ArthurAdmiraal/POxiM-shield/Renders/POxiM-testboard-front_May18th.png

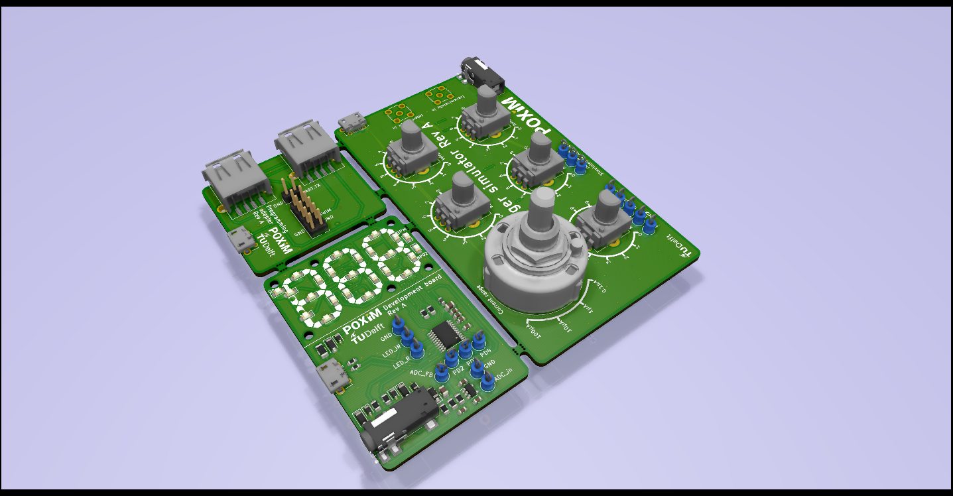
Renders/POxiM-testboard-front_May18th.png
