ArthurAdmiraal/POxiM-shield/Renders/POxiM-displaytester-front_May15th.png

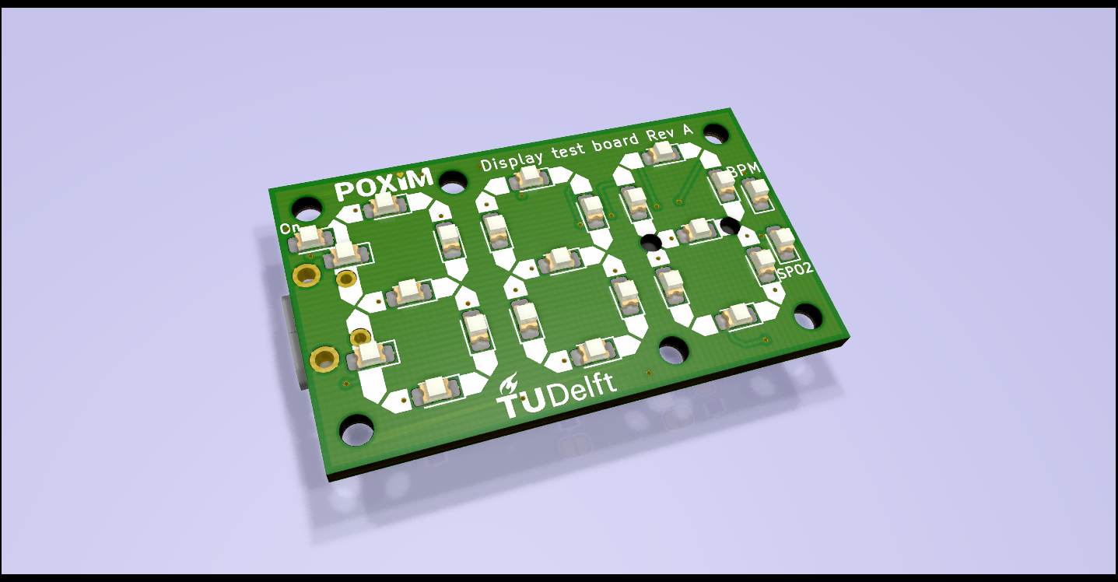
Renders/POxiM-displaytester-front_May15th.png
