ArthurAdmiraal/POxiM-shield/README.md

# POxiM-shield
 Prototyping Arduino shield for POxiM Pulse/Oxymeter
