ArthurAdmiraal/POxiM-shield/Documentation/FingerSensor-schematic-overview.png

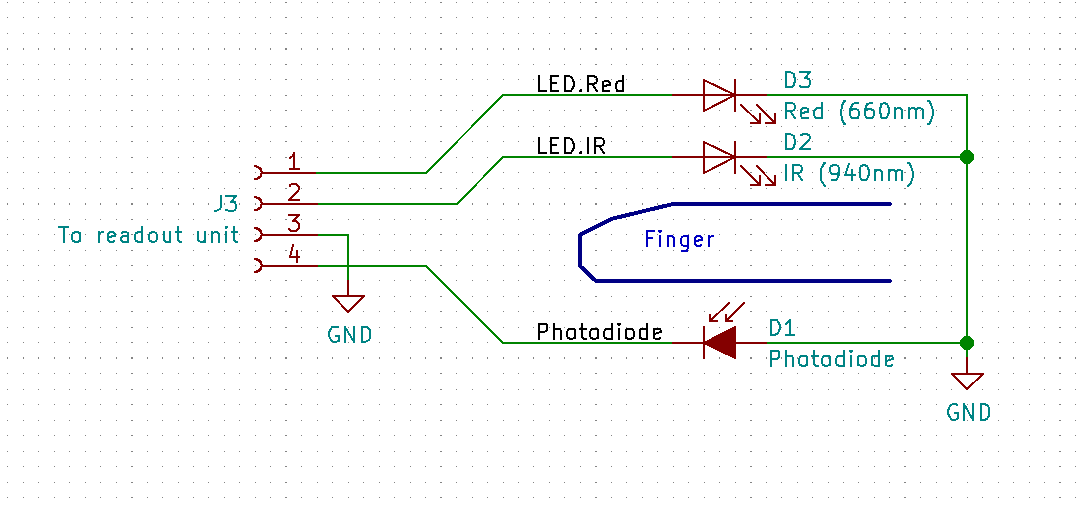
Documentation/FingerSensor-schematic-overview.png
