ArthurAdmiraal/POxiM-shield/Documentation/POxiM-bedofnails-overview.png

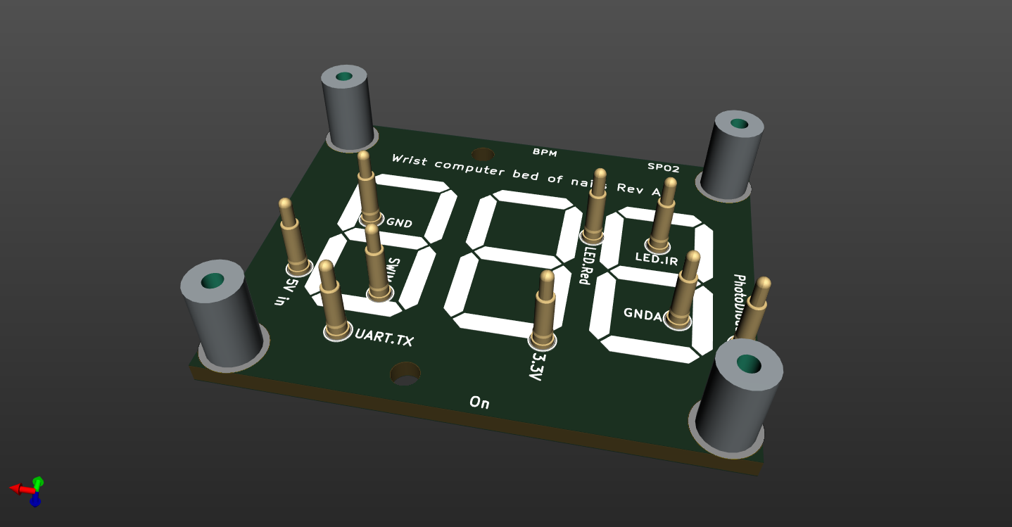
Documentation/POxiM-bedofnails-overview.png
