ArthurAdmiraal/POxiM-shield/Documentation/POxiM-wristcomputer-block diagram.png

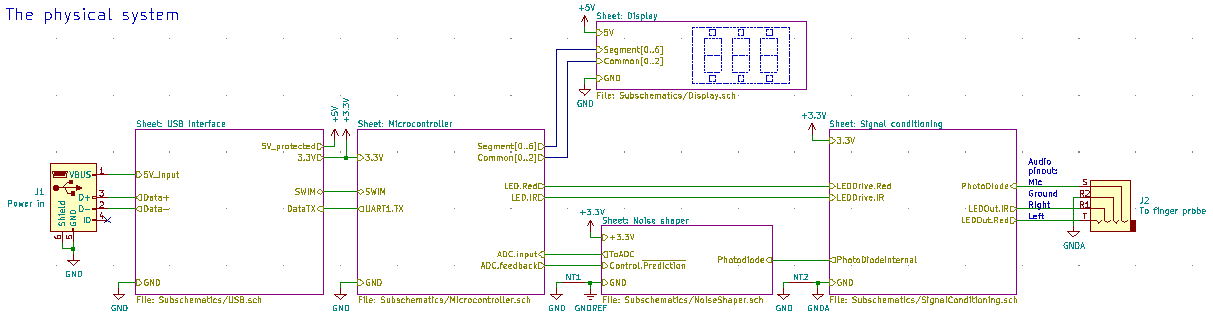
Documentation/POxiM-wristcomputer-block diagram.png
