ArthurAdmiraal/POxiM-shield/Documentation/POxiM-wristcomputer-headon.png

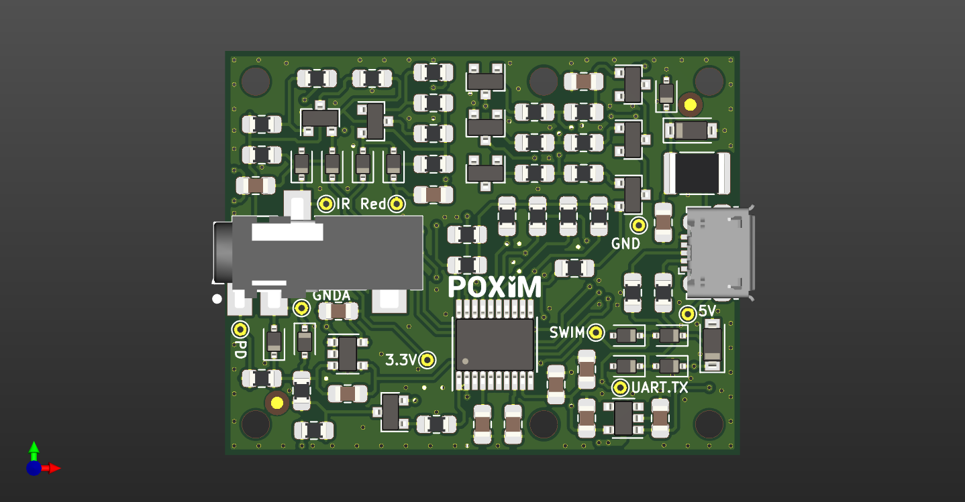
Documentation/POxiM-wristcomputer-headon.png
