ArthurAdmiraal/POxiM-shield/Figures/Coupling_nobias.png

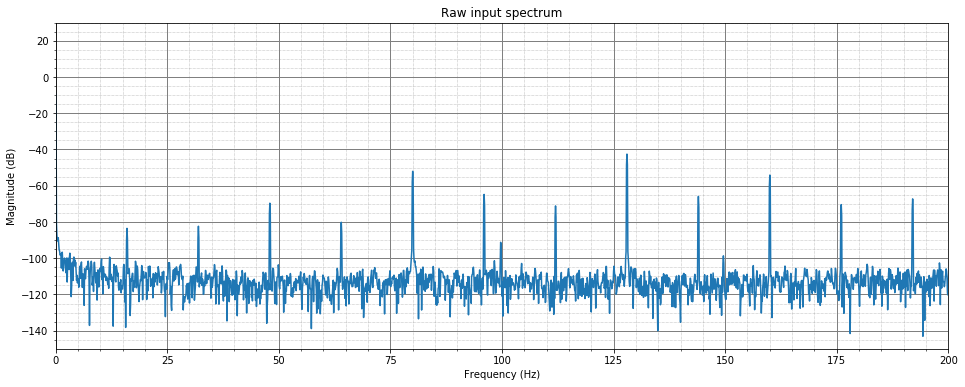
Figures/Coupling_nobias.png
