ArthurAdmiraal/POxiM-shield/Figures/POxiM-SignalChain-MidLevel.png

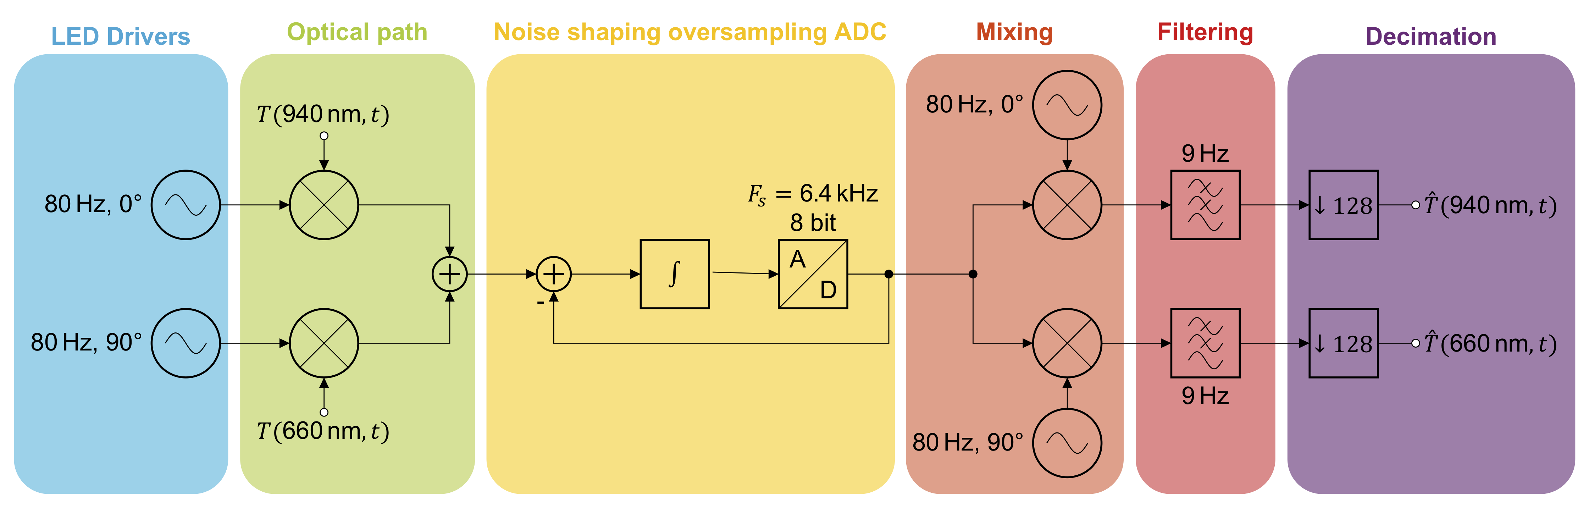
Figures/POxiM-SignalChain-MidLevel.png
