ArthurAdmiraal/POxiM-shield/Mechanical/Decals/POxiM-wristcomputer-Back.png

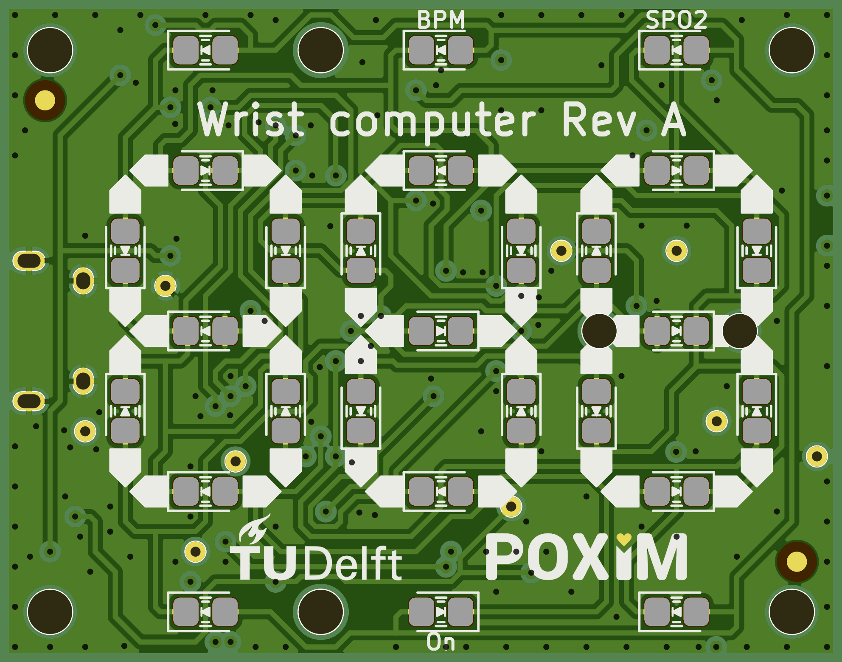
Mechanical/Decals/POxiM-wristcomputer-Back.png
