ArthurAdmiraal/POxiM-shield/Mechanical/Decals/POxiM-wristcomputer-Front.png

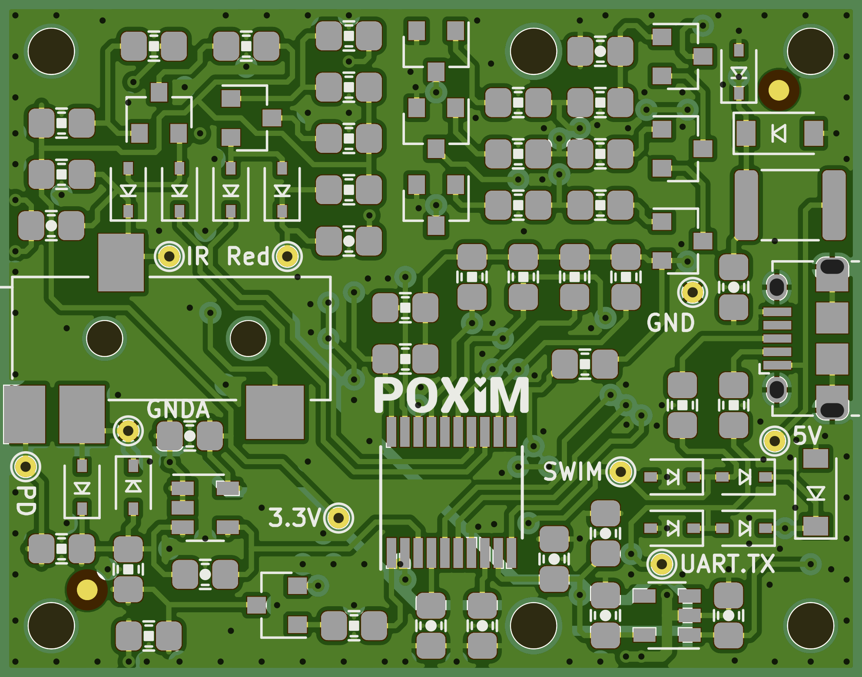
Mechanical/Decals/POxiM-wristcomputer-Front.png
