ArthurAdmiraal/POxiM-shield/Renders/POxiM-displaytester-back_May15th.png

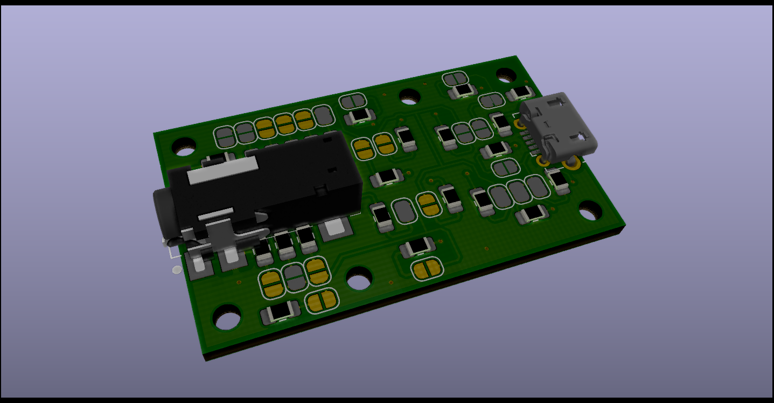
Renders/POxiM-displaytester-back_May15th.png
