ArthurAdmiraal/POxiM-shield/Renders/POxiM-wristcomputer-back_July3rd.png

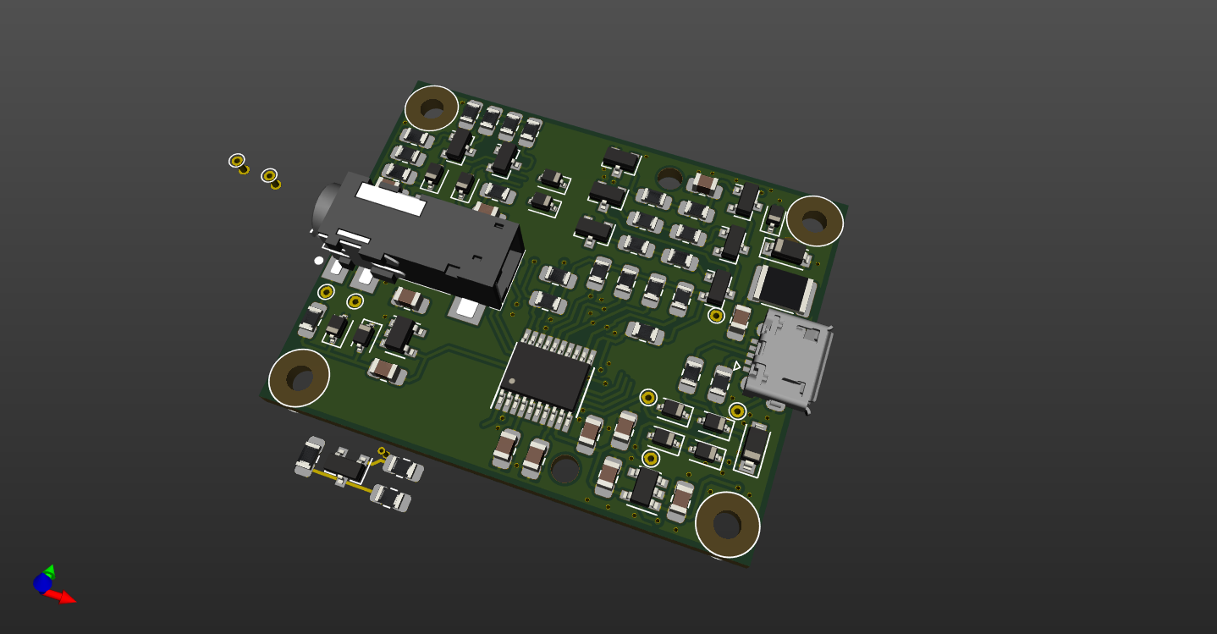
Renders/POxiM-wristcomputer-back_July3rd.png
