ArthurAdmiraal/POxiM-shield/Renders/POxiM-wristcomputer-back_July5th.png

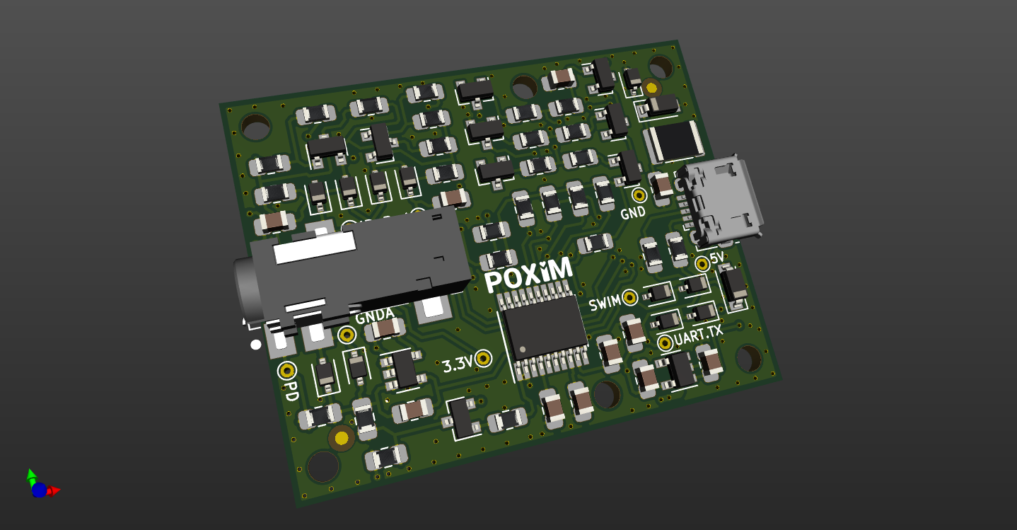
Renders/POxiM-wristcomputer-back_July5th.png
