ArthurAdmiraal/POxiM-shield/Renders/POxiM-wristcomputer-back_May15th.png

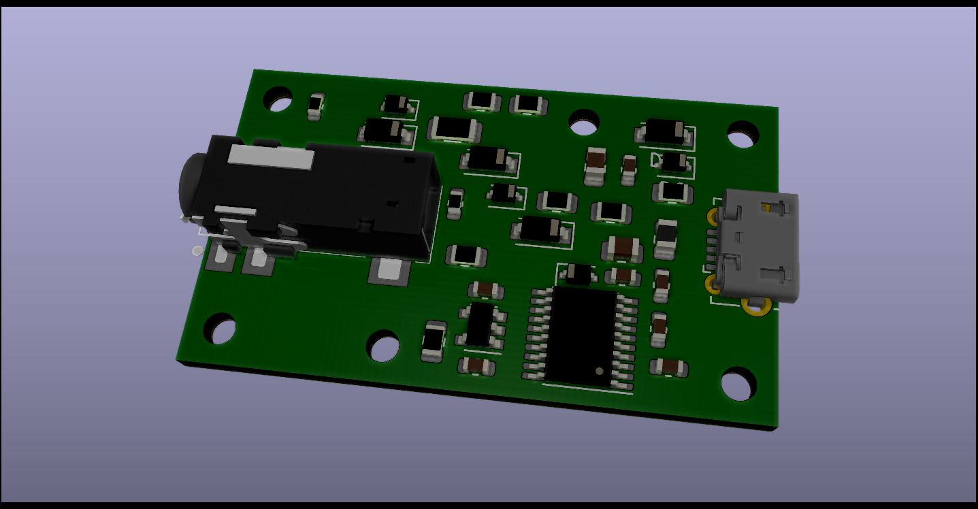
Renders/POxiM-wristcomputer-back_May15th.png
