ArthurAdmiraal/POxiM-shield/Renders/POxiM-wristcomputer-front_July3rd.png

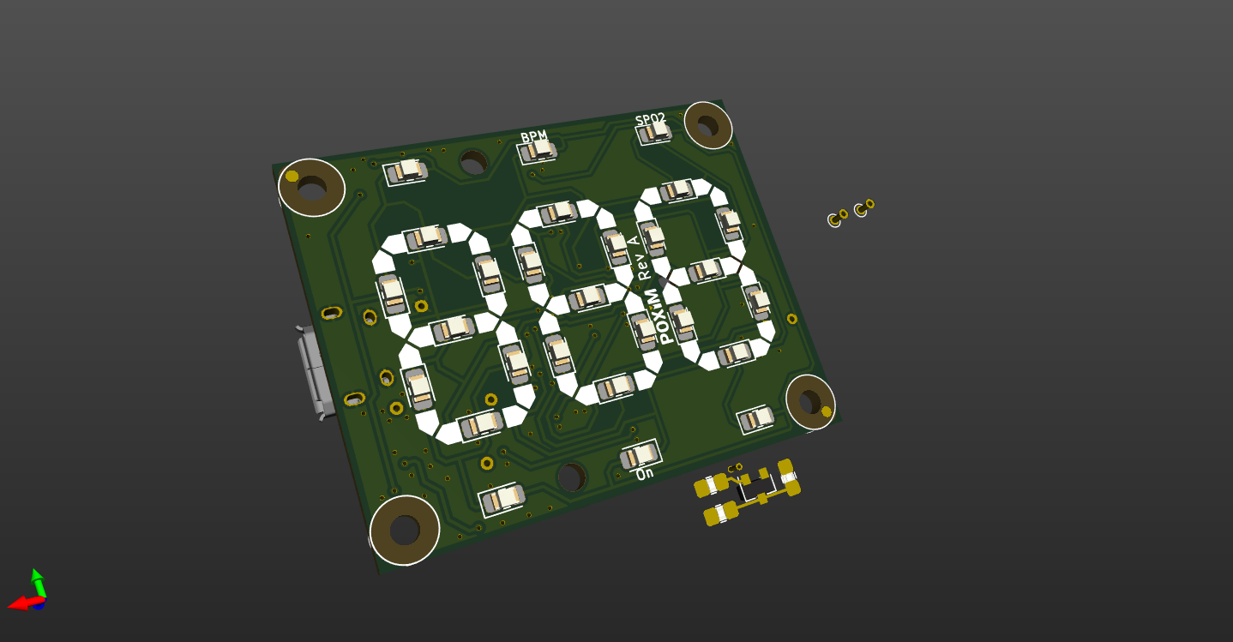
Renders/POxiM-wristcomputer-front_July3rd.png
