ArthurAdmiraal/POxiM-shield/Renders/POxiM-wristcomputer-front_July5th.png

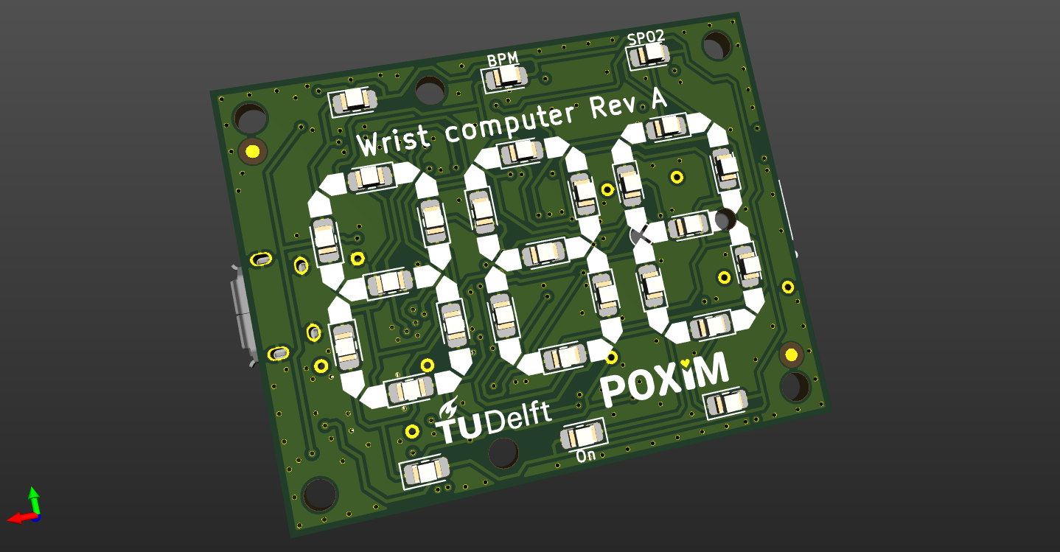
Renders/POxiM-wristcomputer-front_July5th.png
