ArthurAdmiraal/POxiM-shield/Renders/POxiM-wristcomputer-front_May15th.png

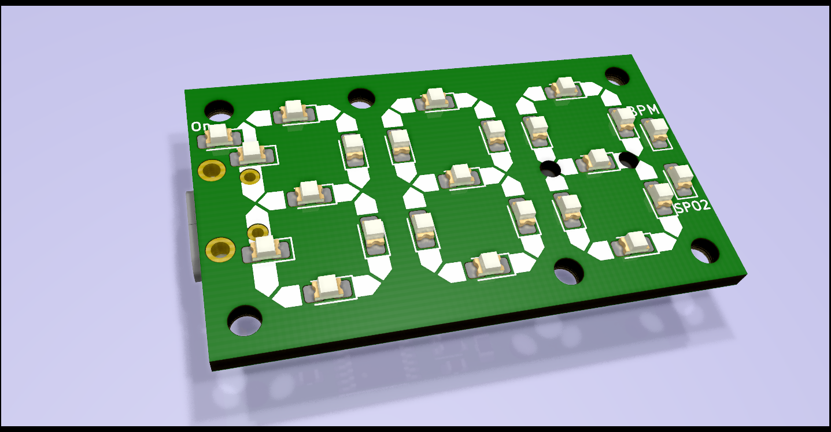
Renders/POxiM-wristcomputer-front_May15th.png
