ArthurAdmiraal/POxiM-shield/Fabrication/AssemblyDiagram.pdf

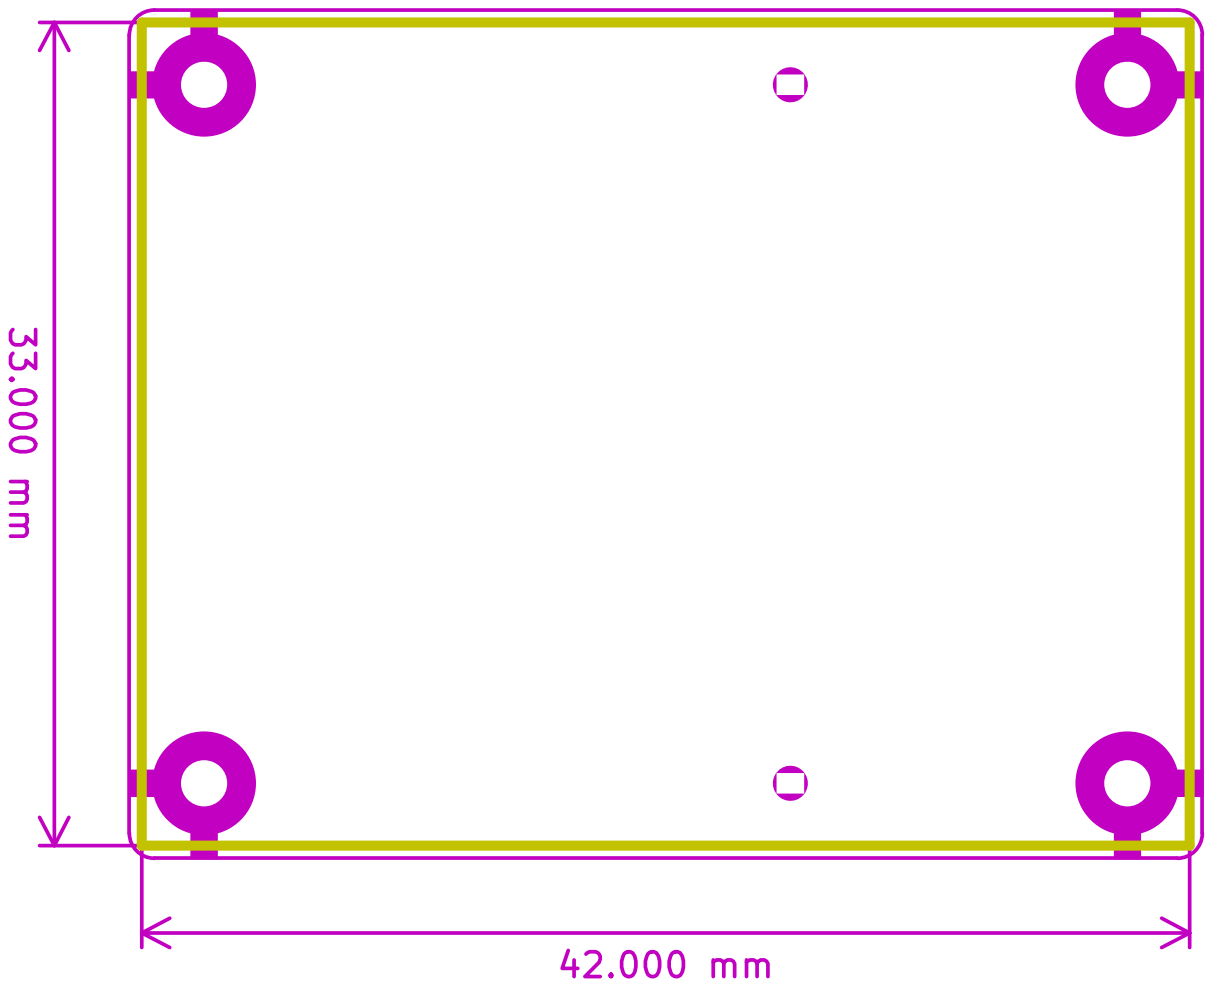
[picture p18: page 1]

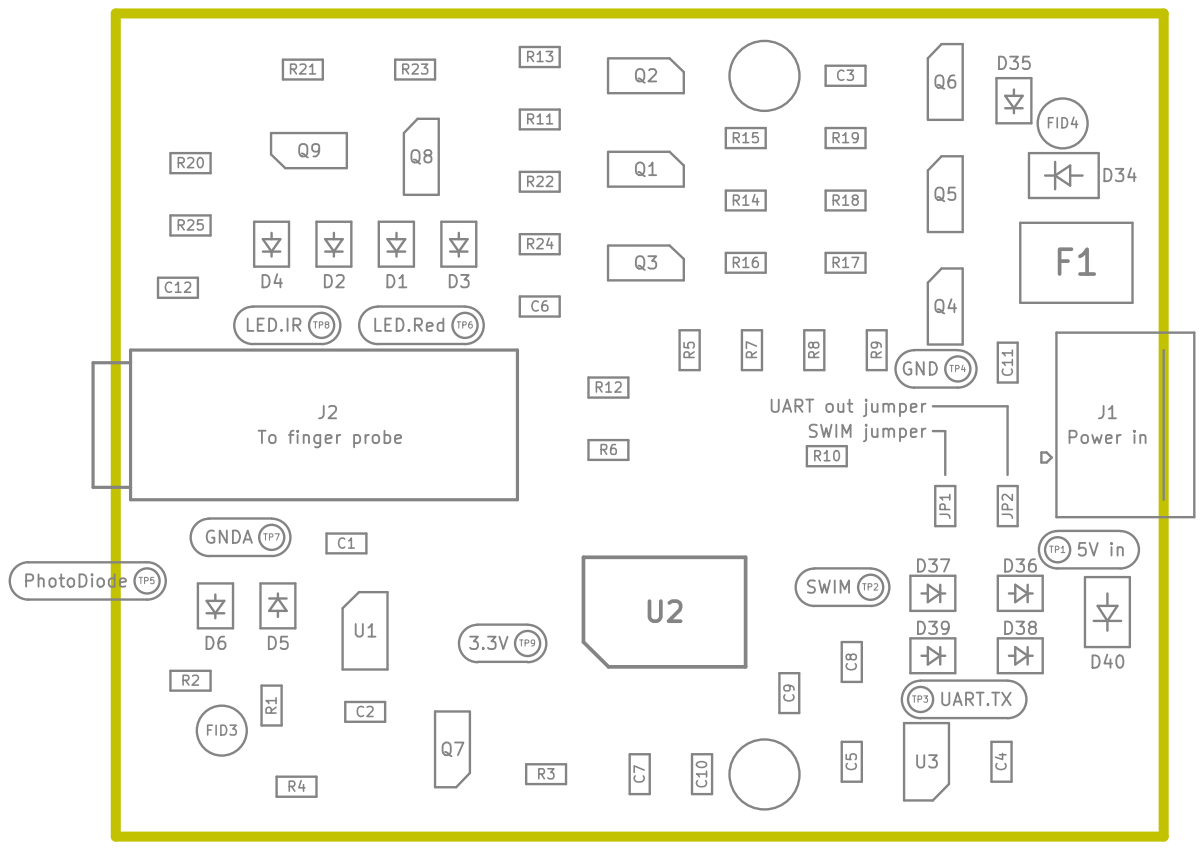
[picture p19: page 2]

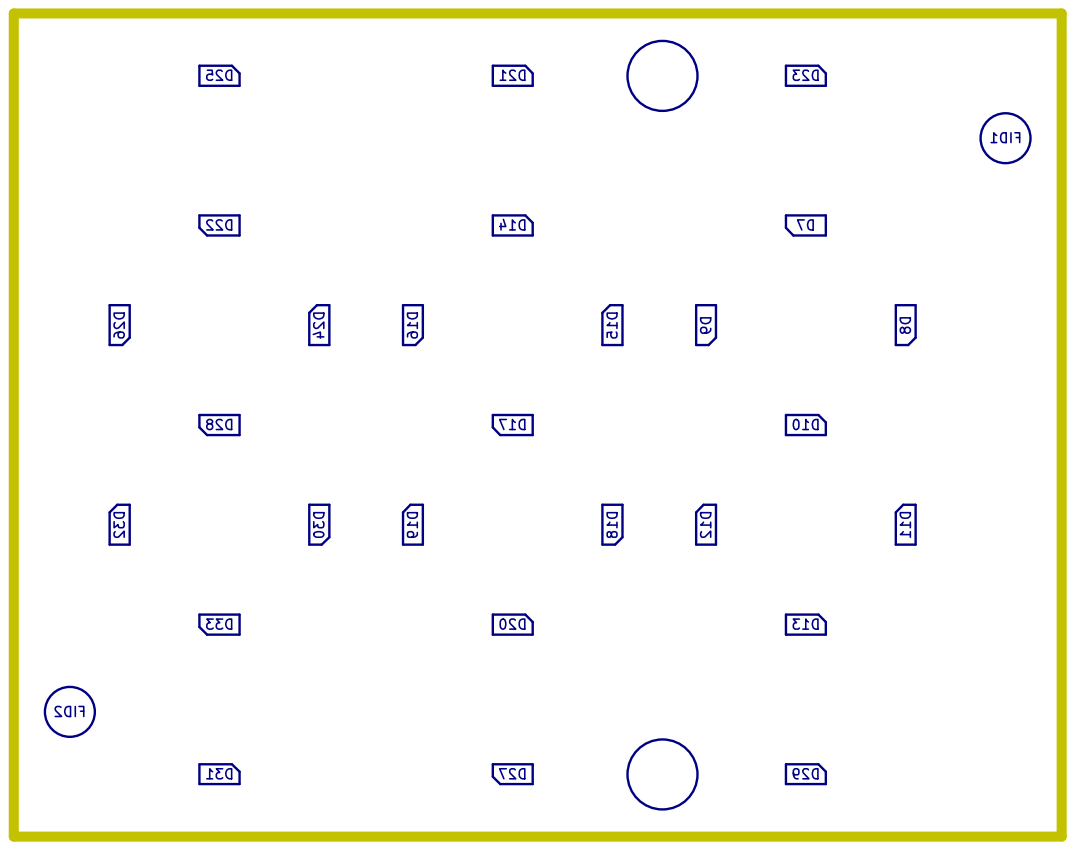
[picture p20: page 3]
