ArthurAdmiraal/POxiM-shield/Simulations/RiseTimeTest.asc

Q1: pnp; 2N3906
R1: res; 100k
R2: res; 4.7Meg
R3: res; 100k
V1: voltage; 3.3V
V2: voltage; PULSE(3.3V 0V 1m 10n 10n 1m 2m 1)
Named nets: 0
.tran 0 3m 0 10n
