ArthurAdmiraal/POxiM-shield/Simulations/CurrentSourceTest.asc

Q1: pnp
R1: res; 47
R2: res; 1k
R3: res; 3.3k
V1: voltage; 5.5V
V2: voltage; 3.3V
Named nets: 0
.dc V2 0V 5.5V
