ArthurAdmiraal/POxiM-shield/Simulations/IsolationTest.asc

M1: nmos; Si7336ADP
R1: res; 100
V1: voltage; 5.5V
V2: voltage; 5.5V
Named nets: 0
.dc V1 0 5.5V
