ArthurAdmiraal/POxiM-shield/Simulations/MOSCurrentSourceTest.asc

M1: pmos; AO6407
R1: res; 100
V1: voltage; 5.5V
V2: voltage; 3V
V3: voltage; 4.3V
Named nets: 0
.dc V1 0 4.3V
