ArthurAdmiraal/POxiM-shield/POxiM-wristcomputer.kicad_pcb

## KiCad design POxiM-wristcomputer.kicad_pcb (2020-07-16)

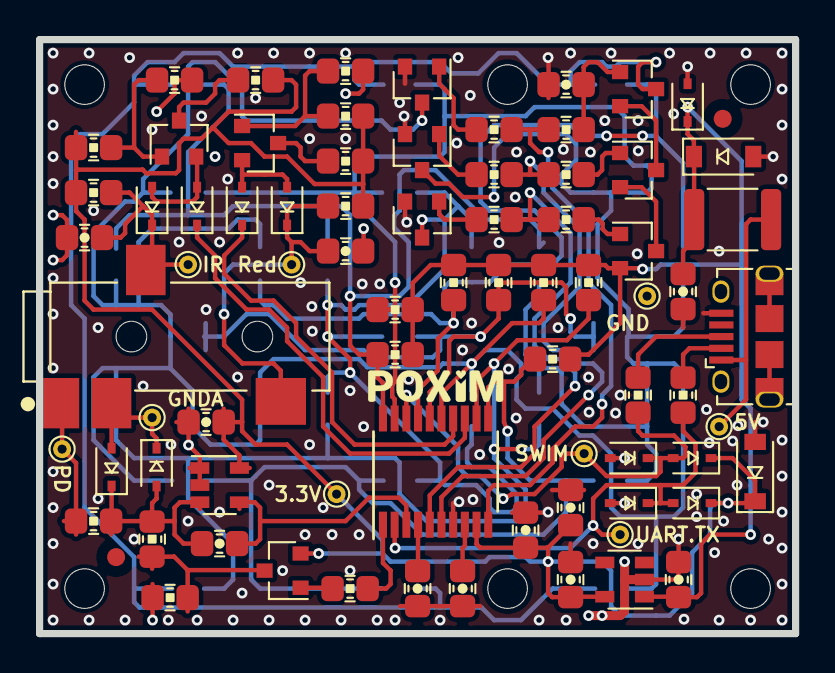
[picture p27: board POxiM-wristcomputer.kicad_pcb from above]

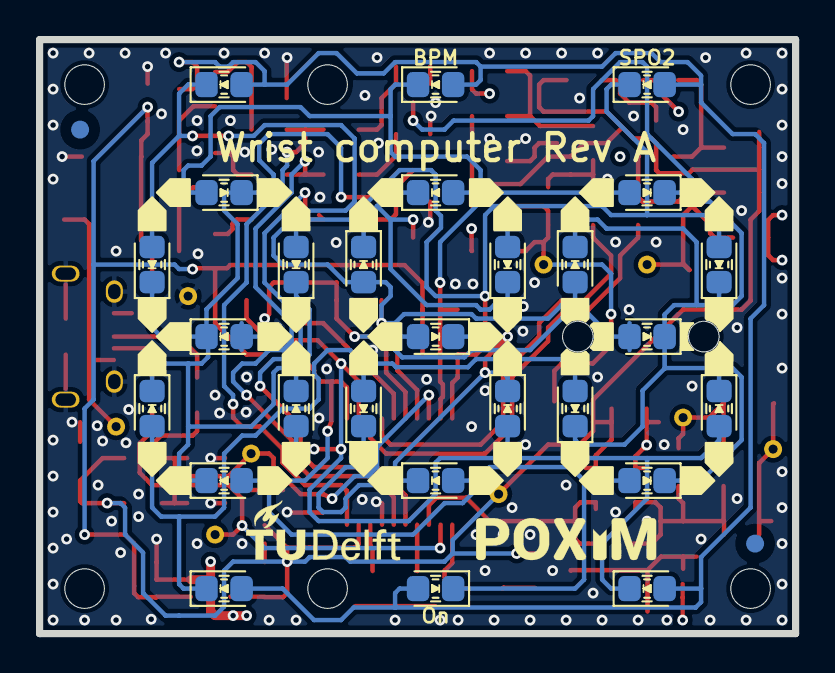
[picture p28: board POxiM-wristcomputer.kicad_pcb from below]

Board: 4 copper layers, 42.0 x 33.0 mm, 115 parts (35 on the bottom side), 50 nets.

Parts:
C1, C3, C7, C9, C11: 100nF; C_0805_2012Metric_0603_1608Metric
C2: 39pF; C_0805_2012Metric_0603_1608Metric
C4, C5, C6, C8, C12: 2.2µF; C_0805_2012Metric_0603_1608Metric
C10: 470nF; C_0805_2012Metric_0603_1608Metric
D1, D2, D3, D4, D5, D6, D35, D36, D37, D38, D39: Schottky; D_SOD-323
D7, D8, D9, D10, D11, D12, D13, D14, D15, D16, D17, D18, D19, D20, D21, D22, D23, D24, D25, D26, D27, D28, D29, D30, D31, D32, D33: LED; LED_0805_2012Metric_0603_1608Metric
D34: 6.8V; D_SOD-123
D40: 5.6V; D_SOD-123
F1: 500mA; R_1812_4532Metric
FID1, FID2, FID3, FID4: Fiducial; Fiducial_1mm_Mask2mm
H1, H2, H3, H4: MountingHole; MountingHole_2.2mm_M2
H5, H6: AlignmentHole; AlignmentHole_2.2mm_M2
J1: Power in; USB_Micro-B_Amphenol_10103594-0001LF_Horizontal
J2: To finger probe; CUI_SJ-43514-SMT
JP1: SWIM jumper; R_0805_2012Metric_0603_1608Metric
JP2: UART out jumper; R_0805_2012Metric_0603_1608Metric
NT1, NT2: Net-Tie_2; NetTie-2_SMD_Pad0.5mm
Q1, Q2, Q3: MMBT3904,215; SOT-23
Q4, Q5, Q6, Q7, Q8, Q9: PMBT3906,215; SOT-23
R1: 4.7MΩ; R_0805_2012Metric_0603_1608Metric
R2, R24, R25: 33kΩ; R_0805_2012Metric_0603_1608Metric
R3, R4: 100kΩ; R_0805_2012Metric_0603_1608Metric
R5, R6, R7, R8, R9, R10, R12: 560Ω; R_0805_2012Metric_0603_1608Metric
R11, R20: 2.2kΩ; R_0805_2012Metric_0603_1608Metric
R13, R14, R15, R16, R17, R18, R19, R21: 3.3kΩ; R_0805_2012Metric_0603_1608Metric
R22, R23: 68Ω; R_0805_2012Metric_0603_1608Metric
TP1: 5V in; TestPoint_THTPad_D1.0mm_Drill0.5mm
TP2: SWIM; TestPoint_THTPad_D1.0mm_Drill0.5mm
TP3: UART.TX; TestPoint_THTPad_D1.0mm_Drill0.5mm
TP4: GND; TestPoint_THTPad_D1.0mm_Drill0.5mm
TP5: PhotoDiode; TestPoint_THTPad_D1.0mm_Drill0.5mm
TP6: LED.Red; TestPoint_THTPad_D1.0mm_Drill0.5mm
TP7: GNDA; TestPoint_THTPad_D1.0mm_Drill0.5mm
TP8: LED.IR; TestPoint_THTPad_D1.0mm_Drill0.5mm
TP9: 3.3V; TestPoint_THTPad_D1.0mm_Drill0.5mm
U1: LM321; SOT-23-5
U2: STM8S003F3P; TSSOP-20_4.4x6.5mm_P0.65mm
U3: MIC5504-3.3YM5; SOT-23-5

Connections:
+3V3: C1.1, C5.1, C8.1, C9.1, D36.1, D38.1, D40.1, Q7.2, R11.2, R20.2, R22.2, R23.2, R24.2, R25.2, TP9.1, U1.5, U2.9, U3.5
+5V: C4.1, C11.1, D34.1, D35.1, F1.1, Q4.2, R5.1, R6.1, R7.1, R8.1, R9.1, R10.1, R12.1, U3.1
/Display/Common0: R14.2, R18.2, U2.6
/Display/Common1: R16.2, R17.2, U2.5
/Display/Common2: R15.2, R19.2, U2.10
/Display/Segment0: D7.2, D14.2, D21.1, D22.2, R12.2, U2.19
/Display/Segment1: D8.2, D15.2, D23.1, D24.2, R5.2, U2.17
/Display/Segment2: D9.2, D16.2, D25.1, D26.2, R6.2, U2.20
/Display/Segment3: D10.2, D17.2, D28.2, R7.2, U2.16
/Display/Segment4: D11.2, D18.2, D29.1, D30.2, R8.2, U2.15
/Display/Segment5: D12.2, D19.2, D31.1, D32.2, R9.2, U2.12
/Display/Segment6: D13.2, D20.2, D27.1, D33.2, R10.2, U2.11
/Microcontroller/ADC.feedback: R3.1, U2.1
/Microcontroller/ADC.input: C2.1, U1.4, U2.3
/Microcontroller/LED.IR: D2.1, U2.13
/Microcontroller/LED.Red: D1.1, U2.14
/Microcontroller/NRST: C7.1, U2.4
/Microcontroller/SWIM: D36.2, D37.1, JP1.2, TP2.1, U2.18
/Microcontroller/VCAP: C10.1, U2.8
/Signal conditioning/LEDOut.IR: C12.1, D4.1, J2.R1, R25.1, TP8.1
/Signal conditioning/LEDOut.Red: C6.1, D3.1, J2.T, R24.1, TP6.1
/Signal conditioning/PhotoDiode: J2.S, R2.2, TP5.1
/Signal conditioning/PhotoDiodeInternal: C2.2, D5.2, D6.1, R1.1, R2.1, U1.3
/USB interface/5V_input: F1.2, J1.1, TP1.1
/USB interface/Data+: J1.3, JP1.1
/USB interface/Data-: J1.2, JP2.1
/USB interface/DataTX: D38.2, D39.1, JP2.2, TP3.1, U2.2
GND: C3.2, C4.2, C5.2, C7.2, C8.2, C9.2, C10.2, C11.2, D34.2, D35.2, D37.2, D39.2, D40.2, J1.5, J1.6, NT1.1, NT2.1, Q1.2, Q2.2, Q3.2, TP4.1, U2.7, U3.2
GNDA: C6.2, C12.2, D5.1, D6.2, J2.R2, NT2.2, R13.1, R21.1, TP7.1
GNDREF: C1.2, NT1.2, R4.2, U1.1, U1.2
unnamed: C3.1, Q6.1, R19.1
unnamed: D1.2, D3.2, Q8.2
unnamed: D2.2, D4.2, Q9.2
unnamed: D7.1, D8.1, D9.1, D10.1, D11.1, D12.1, D13.1, Q1.3
unnamed: D14.1, D15.1, D16.1, D17.1, D18.1, D19.1, D20.1, Q3.3
unnamed: D21.2, D23.2, D25.2, D27.2, D29.2, D31.2, Q6.3
unnamed: D22.1, D24.1, D26.1, D28.1, D30.1, D32.1, D33.1, Q2.3
unnamed: Q1.1, R14.1
unnamed: Q2.1, R15.1
unnamed: Q3.1, R16.1
unnamed: Q4.1, R17.1
unnamed: Q4.3, Q5.2
unnamed: Q5.1, R18.1
unnamed: Q5.3, Q6.2
unnamed: Q7.1, R3.2
unnamed: Q7.3, R1.2, R4.1
unnamed: Q8.1, R11.1, R13.2
unnamed: Q8.3, R22.1
unnamed: Q9.1, R20.1, R21.2
unnamed: Q9.3, R23.1
