ArthurAdmiraal/POxiM-shield/(commit log)

2020-05-06 Create some example circuits
    [POxiM-shield.kicad_pcb, POxiM-shield.sch]
2020-05-07 Put design options in separate sheets
    [Delta sigma.sch, POxiM-shield.sch, SampleHold1.sch, TimeFreeze1.sch, TimeFreeze2.sch]
2020-05-10 Modify delta sigma for noise shaping with ADC, set analysis goals and analyse up to aliasing
    [Delta sigma.sch, POxiM-shield.sch]
2020-05-13 Initial block diagram, restructing to fit hierarchy
    [Display.sch, Microcontroller.sch, NoiseShaper.sch, POxiM-wristcomputer.kicad_pcb, POxiM-wristcomputer.sch, SignalConditioning.sch, USB.sch]
2020-05-13 schematic donish
    [Display.sch, Microcontroller.sch, NoiseShaper.sch, POxiM-wristcomputer.sch, SignalConditioning.sch, USB.sch]
2020-05-13 Add design note about debugger, remove superfluous files
    [Display.sch, Microcontroller.sch, NoiseShaper.sch, POxiM-wristcomputer.sch, SignalConditioning.sch, USB.sch]
2020-05-14 looks real
    [Display.sch, Microcontroller.sch, NoiseShaper.sch, POxiM-wristcomputer.sch, SignalConditioning.sch, USB.sch]
2020-05-14 big chungus
    [POxiM-wristcomputer.kicad_pcb]
2020-05-14 Draw segments on user layer
    [POxiM-wristcomputer.kicad_pcb]
2020-05-14 reduce digit spacing and export step
    [POxiM-wristcomputer.kicad_pcb]
2020-05-15 Refactor based on feedback from Daniel
    [Display.sch, Microcontroller.sch, NoiseShaper.sch, POxiM-wristcomputer.kicad_pcb, POxiM-wristcomputer.sch, SignalConditioning.sch, USB.sch]
2020-05-15 Export mechanicacal files
    [POxiM-wristcomputer-segments.dxf]
2020-05-15 Finish display tester board Rev A
    [Display.sch, POxiM-displaytester-May15th.step, POxiM-wristcomputer.kicad_pcb, POxiM-wristcomputer.sch]
2020-05-18 Finish works-as prototype design
    [Display.sch, Microcontroller.sch, NoiseShaper.sch, POxiM-wristcomputer.kicad_pcb, POxiM-wristcomputer.sch, SignalConditioning.sch, USB.sch, fake_finger.sch]
2020-05-23 Finalise works-like prototype
    [Display.sch, POxiM-developmentboard-RevA-BOM.xlsx, POxiM-wristcomputer.kicad_pcb, POxiM-wristcomputer.sch, SignalConditioning.sch, USB.sch, fake_finger.sch, heartbeat_led_modulator.sch]
2020-05-28 Add BOM
2020-05-28 Prepare and export schematic
    [Display.sch, Microcontroller.sch, NoiseShaper.sch, POxiM-wristcomputer.sch, SignalConditioning.sch, USB.sch, fake_finger.sch, heartbeat_led_modulator.sch]
2020-06-10 Start new LED drive method, some cleanup
    [Display.sch, Microcontroller.sch, NoiseShaper.sch, POxiM-wristcomputer.kicad_pcb, POxiM-wristcomputer.sch, SignalConditioning.sch, USB.sch]
2020-06-11 Finish signal conditioning cleanup, start reworking display
    [Display.sch, POxiM-wristcomputer.sch, SignalConditioning.sch]
2020-06-15 Cleanup most of schematic
    [Display.sch, Microcontroller.sch, NoiseShaper.sch, POxiM-wristcomputer.sch, SignalConditioning.sch, USB.sch]
2020-07-01 Start reworking sing supply ripple issues.
    [Display.sch, Microcontroller.sch, NoiseShaper.sch, POxiM-developmentboard-RevA-BOM.xlsx, POxiM-wristcomputer.csv, POxiM-wristcomputer.kicad_pcb, POxiM-wristcomputer.sch, SignalConditioning.sch]
2020-07-02 Initial PCB layout
    [Display.sch, Microcontroller.sch, NoiseShaper.sch, POxiM-wristcomputer.kicad_pcb, POxiM-wristcomputer.sch, SignalConditioning.sch, USB.sch]
2020-07-05 Finalise wrist computer rev A
    [Display.sch, Microcontroller.sch, POxiM-wristcomputer.kicad_pcb, POxiM-wristcomputer.sch, SignalConditioning.sch, USB.sch]
2020-07-05 Cosmetic silkscreen changes, cleanup old files
    [POxiM-developmentboard-RevA-BOM.xlsx, POxiM-displaytester-May15th.step, POxiM-wristcomputer-segments.dxf, POxiM-wristcomputer.kicad_pcb, fake_finger.sch, heartbeat_led_modulator.sch]
2020-07-07 Update BOM
    [Display.sch, Microcontroller.sch, NoiseShaper.sch, POxiM-wristcomputer.sch, SignalConditioning.sch, USB.sch]
2020-07-16 Finish first schematic version
    [Display.sch, Microcontroller.sch, NoiseShaper.sch, POxiM-wristcomputer-BOM.xls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]
2020-09-07 Add supporting simulations, export BOM
    [POxiM-wristcomputer-BOM.xls]
